LaLaLandExists/power-telemeterv2/schematics/gateway.pdf

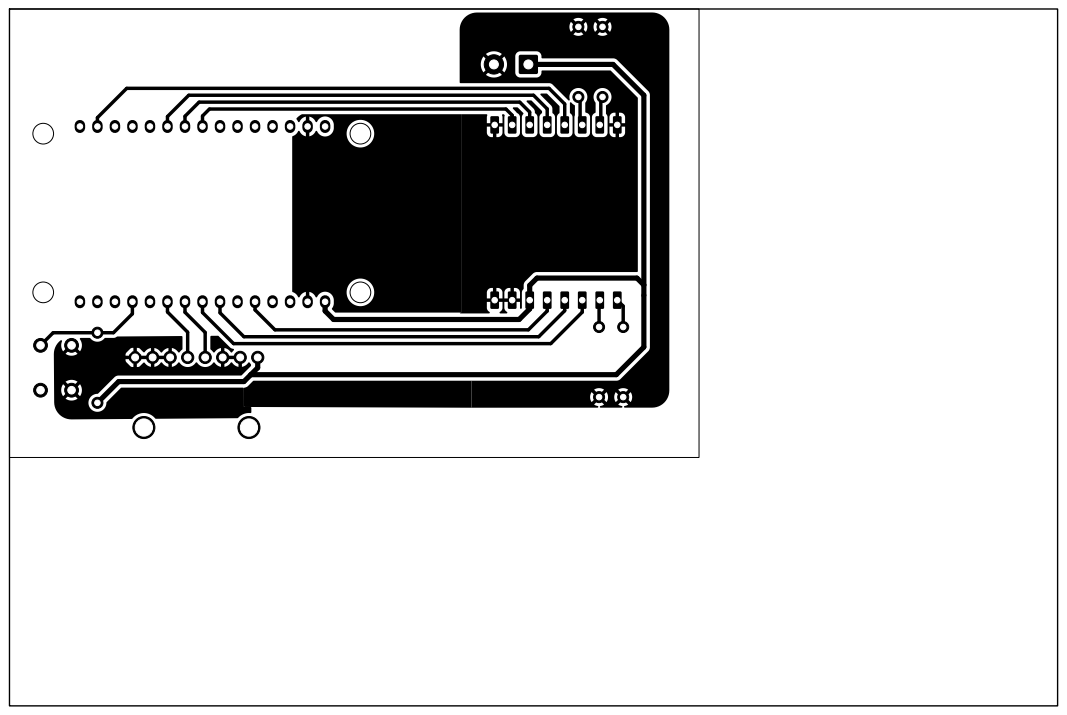
[picture p1: page 1]
