LaLaLandExists/power-telemeterv2/schematics/gateway/gateway-Edge_Cuts.pdf

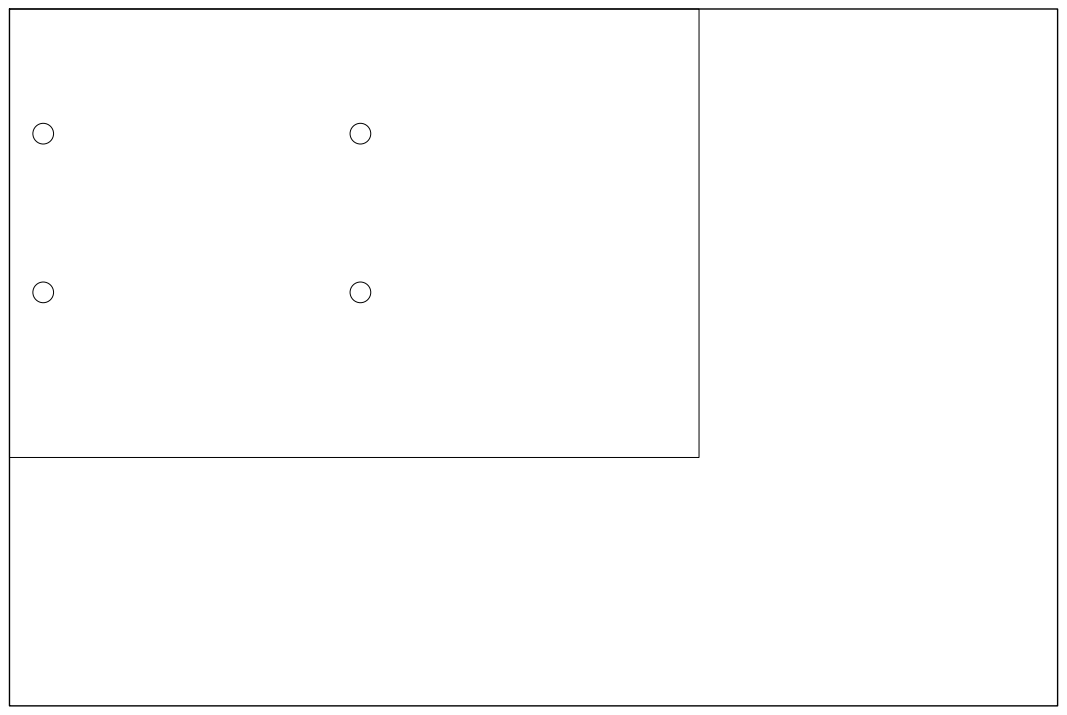
[picture p2: page 1]
