LaLaLandExists/power-telemeterv2/schematics/gateway/gateway-F_Cu.pdf

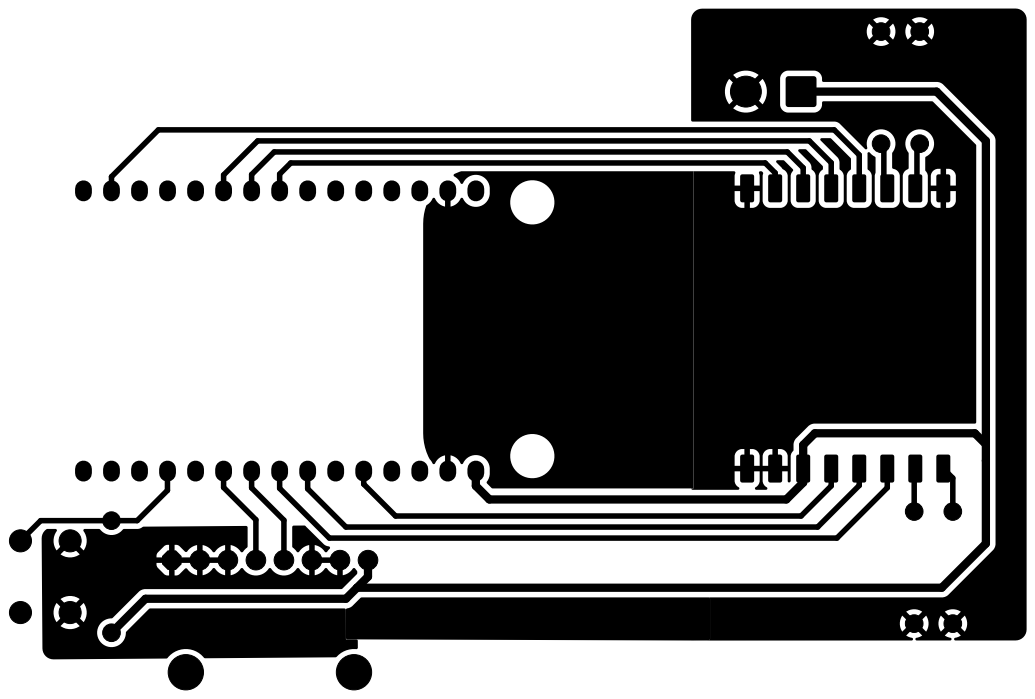
[picture p3: page 1]
