LaLaLandExists/power-telemeterv2/gateway.pdf

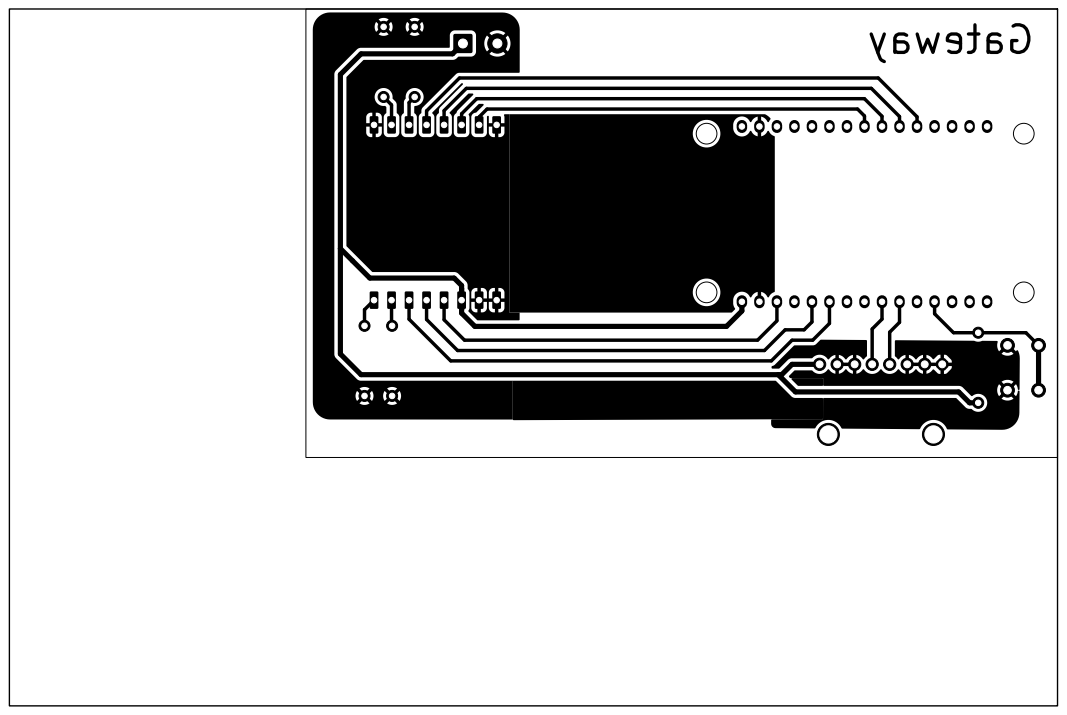
[picture p4: page 1]
