LaLaLandExists/power-telemeterv2/telemetry.pdf

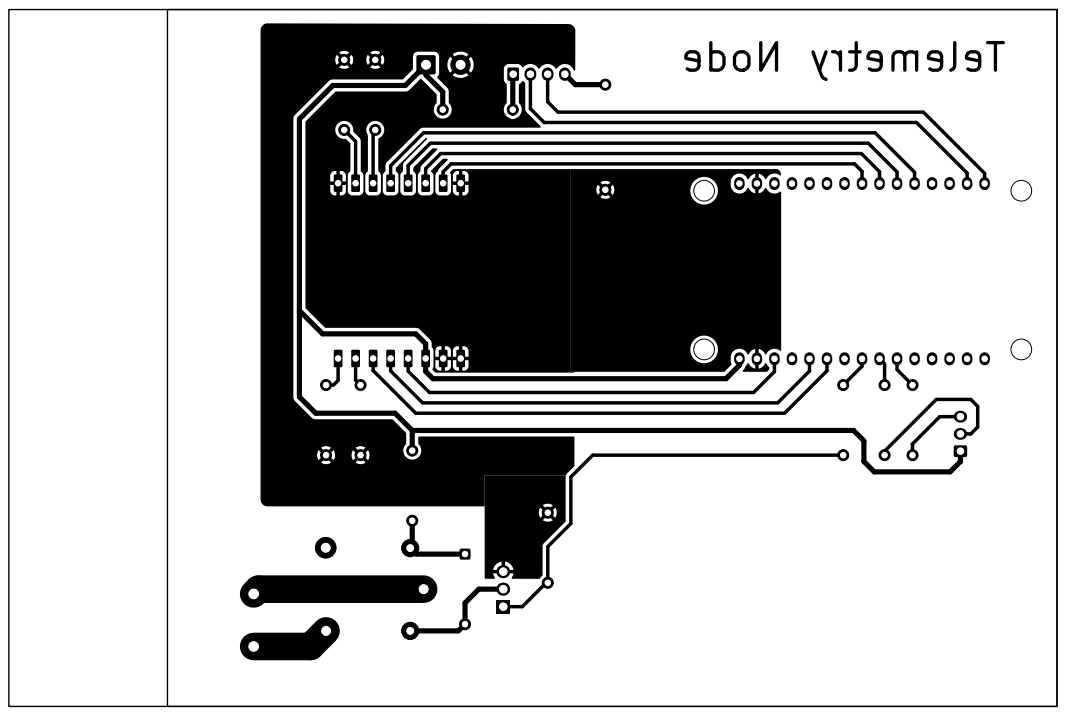
[picture p5: page 1]
