LaLaLandExists/power-telemeterv2/schematics/gateway/gateway.kicad_pcb

## KiCad design schematics/gateway/gateway.kicad_pcb (2026-05-04)

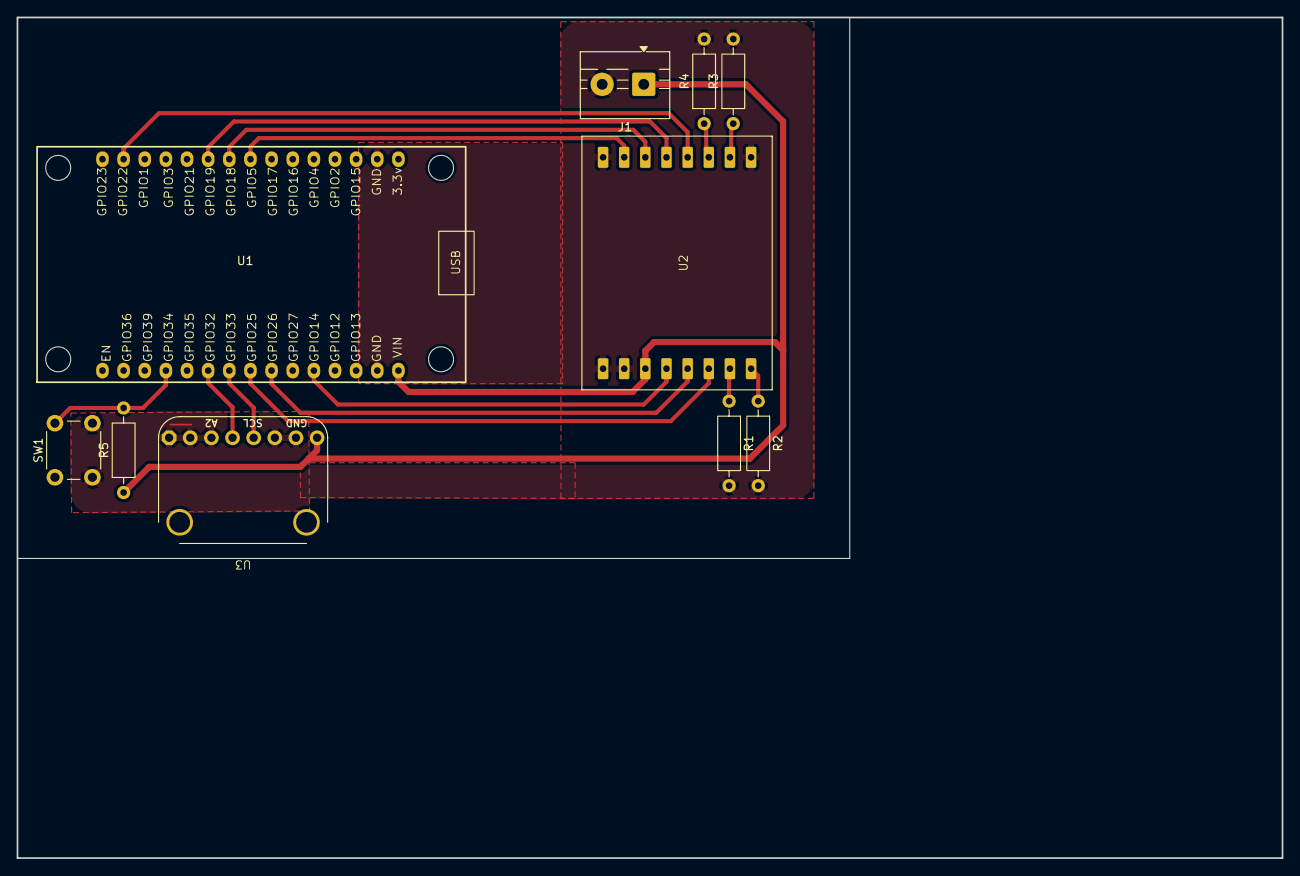
[picture p6: board gateway.kicad_pcb from above]

Board: 2 copper layers, 152.0 x 101.0 mm, 10 parts (0 on the bottom side), 16 nets.

Parts:
J1: Power; TerminalBlock_MaiXu_MX126-5.0-02P_1x02_P5.00mm
R1, R2, R3, R4, R5: 10k; R_Axial_DIN0207_L6.3mm_D2.5mm_P10.16mm_Horizontal
SW1: SW_Push; SW_PUSH_6mm
U1: ESP32_30pin
U2: LoRa-02
U3: frami2c

Connections:
3V3: J1.1, R5.1, U1.1 (VIN), U2.2 (3V3), U3.8 (VCC)
/FRAM_SCL: U1.9 (GPIO33), U3.5 (SCL)
/FRAM_SDA: U1.10 (GPIO32), U3.4 (SDA)
/LoRa_DIO0: U1.7 (GPIO26), U2.4 (DIO0)
/LoRa_DIO1: U1.8 (GPIO25), U2.5 (DIO1)
/LoRa_MISO: U1.25 (GPIO19), U2.12 (MISO)
/LoRa_MOSI: U1.24 (GPIO18), U2.11 (MOSI)
/LoRa_NSS: U1.23 (GPIO5), U2.10 (NSS)
/LoRa_RST: U1.5 (GPIO14), U2.3 (RST)
/LoRa_SCK: U1.29 (GPIO22), U2.13 (SCK)
GND: J1.2, R1.2, R2.2, R3.2, R4.2, SW1.2, U1.2 (GND), U1.17 (GND), U2.1 (GND), U3.1 (A0), U3.2 (A1), U3.3 (A2), U3.6 (WP), U3.7 (GND)
unnamed: R5.2, SW1.1, U1.12 (GPIO34)
unnamed: R1.1, U2.6 (DIO2)
unnamed: R2.1, U2.7 (DIO3)
unnamed: R3.1, U2.8 (DIO4)
unnamed: R4.1, U2.9 (DIO5)
