LaLaLandExists/power-telemeterv2/src/main.cpp

/**
 * main.cpp
 *
 * Unified entry point for the Power Telemetry firmware.
 * Compiles as either a Gateway or a Sensor Node depending on the
 * build flag defined in platformio.ini.
 *
 * -- Usage ---------------------------------------------------------------------
 *
 *   In platformio.ini, set exactly ONE of:
 *
 *     build_flags = -D NODE_GATEWAY
 *     build_flags = -D NODE_TELEMETRY
 *
 *   If BOTH are defined, the build resolves to NODE_GATEWAY (with a warning).
 *   If NEITHER is defined, the build fails with a descriptive #error.
 *
 * -- platformio.ini example ----------------------------------------------------
 *
 *   [env:gateway]
 *   platform  = espressif32
 *   board     = esp32dev
 *   framework = arduino
 *   build_flags =
 *       -D NODE_GATEWAY
 *       -D ARDUINO_USB_CDC_ON_BOOT=0
 *   board_build.filesystem = littlefs
 *   lib_deps =
 *       jgromes/RadioLib @ ^6.0.0
 *       me-no-dev/ESPAsyncWebServer
 *       me-no-dev/AsyncTCP
 *       bblanchon/ArduinoJson @ ^7.0.0
 *
 *   [env:node]
 *   platform  = espressif32
 *   board     = esp32dev
 *   framework = arduino
 *   build_flags =
 *       -D NODE_TELEMETRY
 *       -D ARDUINO_USB_CDC_ON_BOOT=0
 *   lib_deps =
 *       jgromes/RadioLib @ ^6.0.0
 *       olehs/PZEM004Tv30
 *
 * -- Hardware ------------------------------------------------------------------
 *
 *   SX1278 (VSPI - identical on both roles):
 *     NSS  -> GPIO5    SCK  -> GPIO21
 *     MISO -> GPIO19   MOSI -> GPIO18
 *     DIO0 -> GPIO14   RST  -> GPIO13
 *     DIO1 -> GPIO27 (tie to GND if unused)
 *
 *   Gateway only:
 *     WiFi + LittleFS (index.html + wifi_config.html in data/ folder)
 *     Dashboard: http://telemeter.local  or  http://192.168.4.1
 *
 *   Node only:
 *     PZEM-004T v3  -> Serial2  PZEM_RX=GPIO22, PZEM_TX=GPIO23
 *     Relay signal  -> GPIO25 (active HIGH)
 *     LED green     -> GPIO32
 *     LED red       -> GPIO33
 */

// --- Macro resolution ---------------------------------------------------------
#if defined(NODE_GATEWAY) && defined(NODE_TELEMETRY)
  // Both defined - resolve to gateway with a compile-time warning.
  // #warning is a GCC extension supported by the ESP32 toolchain.
  #warning "Both NODE_GATEWAY and NODE_TELEMETRY are defined - building as NODE_GATEWAY."
  #undef NODE_TELEMETRY
#elif !defined(NODE_GATEWAY) && !defined(NODE_TELEMETRY)
  #error "No build role defined. Set exactly one of: -D NODE_GATEWAY  or  -D NODE_TELEMETRY"
#endif
// After resolution: exactly one of NODE_GATEWAY or NODE_TELEMETRY is defined.

// --- Common includes (both roles) --------------------------------------------
#include <Arduino.h>
#include <SPI.h>
#include <RadioLib.h>
#include "lora_tdma_protocol.h"
#include "log_async.h"

// --- Role-specific includes ---------------------------------------------------
#ifdef NODE_GATEWAY
  #include <WiFi.h>
  #include <ESPmDNS.h>
  #include <LittleFS.h>
  #include <Wire.h>
  #include "gateway_state.h"
  #include "gateway_tdma_task.h"
  #include "gateway_web.h"
  #include "gateway_wifi_config.h"
  #include "fram_store.h"
#endif

#ifdef NODE_TELEMETRY
  #ifndef PZEM_FAKE
  #include <PZEM004Tv30.h>
  #endif
  #include "node_tdma_task.h"
#endif

// --- Pin definitions (shared) ------------------------------------------------
#define LORA_PIN_NSS    5
#define LORA_PIN_MOSI   18
#define LORA_PIN_MISO   19
#define LORA_PIN_SCK    21
#define LORA_PIN_DIO1   27   // Tie to GND if unused
#define LORA_PIN_DIO0   14
#define LORA_PIN_RST    13

// --- Role-specific pin definitions -------------------------------------------
#ifdef NODE_TELEMETRY
  #define PZEM_RX_PIN  22   // PZEM RX  -> ESP32 TX2
  #define PZEM_TX_PIN  23   // PZEM TX  <- ESP32 RX2
  #define RELAY_PIN_      25  // Relay signal (active HIGH)
  #define LED_GREEN_PIN_  32  // Two-color LED - green channel
  #define LED_RED_PIN_    33  // Two-color LED - red channel

  // Exported - referenced by node_tdma_task.cpp
  uint8_t RELAY_PIN     = RELAY_PIN_;
  uint8_t LED_GREEN_PIN = LED_GREEN_PIN_;
  uint8_t LED_RED_PIN   = LED_RED_PIN_;
#endif

// --- Hardware instances -------------------------------------------------------
// Radio instance - extern-referenced by both gateway_tdma_task.cpp and node_tdma_task.cpp
SX1278 radio = new Module(LORA_PIN_NSS, LORA_PIN_DIO0, LORA_PIN_RST, LORA_PIN_DIO1);

#ifdef NODE_TELEMETRY
  #ifndef PZEM_FAKE
  // PZEM-004T v3 on Serial2 - extern-referenced by node_tdma_task.cpp
  PZEM004Tv30 pzem(Serial2, PZEM_TX_PIN, PZEM_RX_PIN);
  #endif
#endif

// =============================================================================
// GATEWAY
// =============================================================================
#ifdef NODE_GATEWAY

void setup() {
  Serial.begin(115200);
  logDrainTaskStart();
  delay(500);
  Serial.println("\n===== Power Telemetry Gateway =====");

  // -- LittleFS --------------------------------------------------------------
  // Mounts the web SPA (index.html, app.js, etc.) served by the web task.
  // LittleFS.begin(true) formats on mount failure.
  // NVS (WiFi credentials) is unaffected by format.
  if (!LittleFS.begin(true)) {
    Serial.println("[FS] LittleFS mount FAILED - dashboard SPA not available");
  } else {
    Serial.println("[FS] LittleFS OK");
    File root = LittleFS.open("/");
    File f = root.openNextFile();
    while (f) {
      Serial.printf("  /%-30s  %lu B\n", f.name(), (unsigned long)f.size());
      f = root.openNextFile();
    }
  }

  // -- FRAM (MB85RC256V, SDA=32, SCL=33, addr=0x50) -------------------------
  // framLoadAll() is called before the TDMA task starts so no mutex is needed.
  // framInit() internally calls Wire.begin(32, 33).
  if (!framInit(32, 33, 0x50)) {
    Serial.println("[FRAM] Init FAILED - energy/history persistence disabled");
  } else {
    Serial.println("[FRAM] OK");
    framLoadAll();
  }

  // -- WiFi - non-blocking state machine ------------------------------------
  // AP starts immediately (last-resort access route). STA attempted in
  // parallel if credentials are saved in NVS.
  //   AP on  -> while STA unavailable (no creds, connecting, or dropped)
  //   AP off -> only while STA actively connected
  // wifiConfigLoop() drives all transitions from loop().
  wifiConfigBegin();

  // -- SX1278 radio ----------------------------------------------------------
  SPI.begin(LORA_PIN_SCK, LORA_PIN_MISO, LORA_PIN_MOSI, LORA_PIN_NSS);
  Serial.print("[LORA] Initialising SX1278 ... ");
  int16_t loraState = radio.begin(
    LORA_CHANNELS[0],   // Ch 0 - beacon channel
    LORA_BANDWIDTH,
    LORA_SF,
    LORA_CR,
    LORA_SYNC_WORD,
    LORA_TX_POWER,
    LORA_PREAMBLE_LEN
  );
  if (loraState == RADIOLIB_ERR_NONE) {
    Serial.println("OK");
  } else {
    Serial.printf("FAILED (err=%d) - check wiring!\n", loraState);
  }
  radio.setCRC(true);

  // -- Web server ------------------------------------------------------------
  webServerSetup();

  // -- TDMA task (Core 1, priority 2) ---------------------------------------
  gatewayTdmaTaskStart();

  Serial.println("[GW] Setup complete.\n");
}

void loop() {
  // Drive the WiFi state machine and DNS server.
  wifiConfigLoop();

  // Periodic 5 s "nodes" WebSocket push + ws.cleanupClients().
  webBroadcastAllNodes();

  delay(10);
}

#endif // NODE_GATEWAY

// =============================================================================
// SENSOR NODE
// =============================================================================
#ifdef NODE_TELEMETRY

void setup() {
  Serial.begin(115200);
  logDrainTaskStart();
  delay(500);
  Serial.println("\n===== Power Telemetry Node =====");

  // -- GPIO init -------------------------------------------------------------
#ifndef PZEM_FAKE
  pinMode(RELAY_PIN_,      OUTPUT);
  digitalWrite(RELAY_PIN_, LOW);       // Relay OFF at boot
#endif
  pinMode(LED_GREEN_PIN_, OUTPUT);
  digitalWrite(LED_GREEN_PIN_, HIGH);
  pinMode(LED_RED_PIN_,   OUTPUT);
  digitalWrite(LED_RED_PIN_,   HIGH);

  // 3 fast green blinks - boot indicator
  for (int i = 0; i < 6; i++) {
    digitalWrite(LED_GREEN_PIN_, i & 1 ? HIGH : LOW);
    delay(120);
  }
  digitalWrite(LED_GREEN_PIN_, HIGH);

  // -- SX1278 radio ----------------------------------------------------------
  SPI.begin(LORA_PIN_SCK, LORA_PIN_MISO, LORA_PIN_MOSI, LORA_PIN_NSS);
  Serial.print("[LORA] Initialising SX1278 ... ");
  int16_t loraState = radio.begin(
    LORA_CHANNELS[0],   // Ch 0 - listen for beacon
    LORA_BANDWIDTH,
    LORA_SF,
    LORA_CR,
    LORA_SYNC_WORD,
    LORA_TX_POWER,
    LORA_PREAMBLE_LEN
  );
  if (loraState == RADIOLIB_ERR_NONE) {
    Serial.println("OK");
  } else {
    Serial.printf("FAILED (err=%d)\n", loraState);
  }
  radio.setCRC(true);

  // -- PZEM sanity check -----------------------------------------------------
#ifdef PZEM_FAKE
  Serial.println("[PZEM-FAKE] Net-test mode — skipping PZEM hardware check");
#else
  Serial.print("[PZEM] Checking connection ... ");
  delay(200);
  float testV = pzem.voltage();
  if (!isnan(testV)) {
    Serial.printf("OK (%.1f V)\n", testV);
  } else {
    Serial.println("No response - check wiring (TX/RX swapped?)");
    // pzemTask will keep retrying - non-fatal
  }
#endif

  // -- Launch FreeRTOS tasks -------------------------------------------------
  nodeTdmaTaskStart();

  Serial.println("[NODE] Setup complete - waiting for beacon.\n");
}

void loop() {
  // All work is in FreeRTOS tasks on Core 1 (TDMA) and Core 0 (PZEM, sched, nudge).
  // loop() runs as the idle context - just yield.
  vTaskDelay(pdMS_TO_TICKS(1000));
}

#endif // NODE_TELEMETRY
