LaLaLandExists/power-telemeterv2/(commit log)

2026-04-15 added schematics and adjusted pins
    [Adafruit I2C FRAM.kicad_pcb, gateway.kicad_pcb, gateway.kicad_sch, telemetry.kicad_pcb, telemetry.kicad_sch]
2026-05-04 AP-STA fix + fake pzem mode
    fix task starvation issue which prevented tasks from executing. create a testing module for LoRa connectivity
    [gateway.kicad_pcb, telemetry.kicad_sch]
2026-05-05 add pcb pdf for both telemetry and gateway nodes
